Atarity/mixtape-alpha/HW/brd-preview.jpg

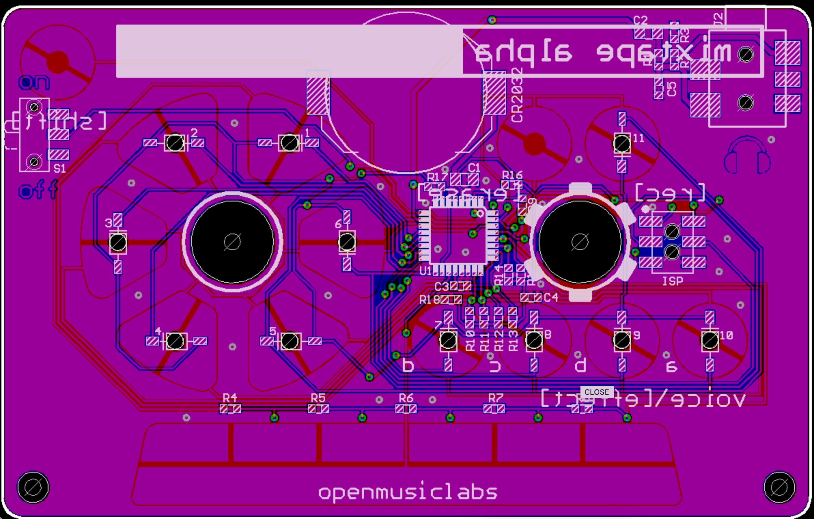
HW/brd-preview.jpg
