Atarity/mixtape-alpha/README.md

# Mixtape Alpha
This is Openmusiclabs project: http://wiki.openmusiclabs.com/wiki/MixtapeAlpha
