Atarity/mixtape-alpha/HW/mixtape2_bom.xlsx

Qty | Parts | Value | Package | Description
3 | C3, C4, C5 | .1uF | 0603-SM
2 | C1, C2 | 10uF | 0805/SMALL
1 | R1 | 100 | 0603-SM
8 | R2, R3, R4, R5, R6, R7, R8, R9 | 10k | 0603-SM
1 | R17 | 2.2k | 0603-SM
8 | R10, R11, R12, R13, R14, R15, R16, R18 | 22M | 0603-SM
11 | 1, 2, 3, 4, 5, 6, 7, 8, 9, 10, 11 | RED | SMD 2.5x2 | Kingbright KM2520SRC03
1 | U1 | ATMEGA328P | 32-TQFP-NOMOD
1 | J2 | Audio jack | 1/8JACK/STEREO/SMT 2SWITCHCUI3515 or KOBICONN2805 | SJ1-3515-SMT-GR
1 | BH1 | CR2032 BK-912 | Batterie holder for cr2032 | BTH-R36-20, L-KLS5-CR2032-09B
1 | S1 | JS102011 | SPDT angled SWITCH/SLIDE/JS102011 | JS102011SAQN
