Atarity/mixtape-alpha/(list of files, cad)

Other CAD files:
FW/mixtape_avr_new/mixtape.obj
