Atarity/mixtape-alpha/HW/mixtape2.brd

## EAGLE design HW/mixtape2.brd (2021-09-27)

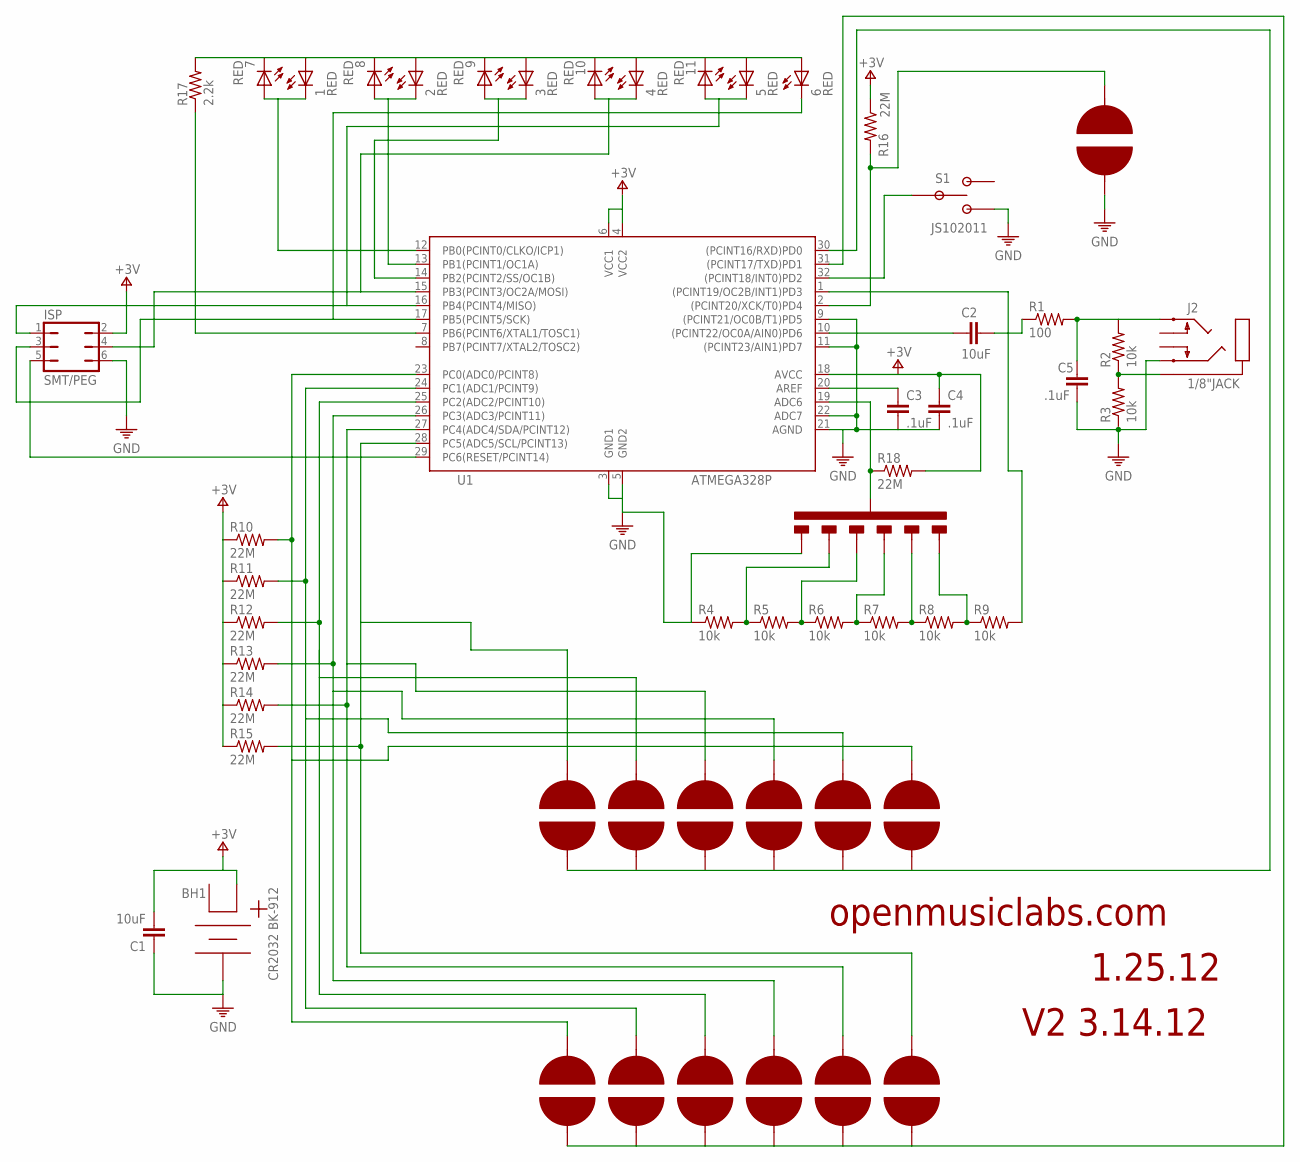
[picture p2: schematic mixtape2.sch]

Parts:
1, 2, 3, 4, 5, 6, 7, 8, 9, 10, 11: RED; LED-SMT-91-21
BH1: CR2032 BK-912; BAT-HOLD-BK-912
C1, C2: 10uF; 0805/SMALL
C3, C4, C5: .1uF; 0603-SM
ISP: SMT/PEG; JMP/6P/DIP/SMT/PEG
J2: 1/8"JACK; 1/8"JACK/STEREO/SMT
R1: 100; 0603-SM
R2, R3, R4, R5, R6, R7, R8, R9: 10k; 0603-SM
R10, R11, R12, R13, R14, R15, R16, R18: 22M; 0603-SM
R17: 2.2k; 0603-SM
S1: JS102011; SWITCH/SLIDE/JS102011
U1: ATMEGA328P; 32-TQFP-NOMOD
U$1: PAD/TOUCH/WHEEL
U$2, U$3, U$4, U$5, U$6, U$7, U$8: PAD/TOUCH; PAD/TOUCH/DOT
U$9: PAD/TOUCH/SLIDERSLIDER; PAD/TOUCH/SLIDER

Connections:
unnamed: R17.P$1 (1), U1.7 (PB6(PCINT6/XTAL1/TOSC1))
unnamed: U1.31 ((PCINT17/TXD)PD1), U$2.P$2, U$3.P$2, U$4.P$2, U$5.P$2, U$6.P$2, U$7.P$2
unnamed: R13.P$2 (2), U1.26 (PC3(ADC3/PCINT11)), U$1.P$7, U$5.P$1
unnamed: U1.30 ((PCINT16/RXD)PD0), U$1.P$2, U$1.P$4, U$1.P$6, U$1.P$8, U$1.P$10, U$1.P$12
unnamed: ISP.5, U1.29 (PC6(RESET/PCINT14))
unnamed: J2.P$1 (1), R2.P$1 (1), R3.P$2 (2)
unnamed: C2.1, R1.P$1 (1)
unnamed: C5.P$1 (1), J2.P$5 (5), R1.P$2 (2), R2.P$2 (2)
unnamed: C2.2, U1.10 ((PCINT22/OC0A/AIN0)PD6)
unnamed: S1.P$2, U1.32 ((PCINT18/INT0)PD2)
unnamed: C3.P$1 (1), U1.20 (AREF)
unnamed: R4.P$2 (2), R5.P$1 (1), U$9.P$6
unnamed: R5.P$2 (2), R6.P$1 (1), U$9.P$5
unnamed: R6.P$2 (2), R7.P$1 (1), U$9.P$4
unnamed: R8.P$2 (2), R9.P$1 (1), U$9.P$2
unnamed: R9.P$2 (2), U1.1 ((PCINT19/OC2B/INT1)PD3)
unnamed: 1.P$1 (C), 7.P$2 (A), U1.12 (PB0(PCINT0/CLKO/ICP1))
unnamed: 2.P$1 (C), 8.P$2 (A), U1.13 (PB1(PCINT1/OC1A))
unnamed: 3.P$1 (C), 9.P$2 (A), U1.14 (PB2(PCINT2/SS/OC1B))
unnamed: 4.P$1 (C), 10.P$2 (A), ISP.4, U1.15 (PB3(PCINT3/OC2A/MOSI))
unnamed: 5.P$1 (C), 11.P$2 (A), ISP.1, U1.16 (PB4(PCINT4/MISO))
unnamed: 1.P$2 (A), 2.P$2 (A), 3.P$2 (A), 4.P$2 (A), 5.P$2 (A), 6.P$2 (A), 7.P$1 (C), 8.P$1 (C), 9.P$1 (C), 10.P$1 (C), 11.P$1 (C), R17.P$2 (2)
unnamed: R16.P$2 (2), U1.2 ((PCINT20/XCK/T0)PD4), U$8.P$1
unnamed: R12.P$2 (2), U1.25 (PC2(ADC2/PCINT10)), U$1.P$3, U$4.P$1
unnamed: R14.P$2 (2), U1.27 (PC4(ADC4/SDA/PCINT12)), U$1.P$5, U$6.P$1
unnamed: R15.P$2 (2), U1.28 (PC5(ADC5/SCL/PCINT13)), U$1.P$1, U$7.P$1
unnamed: R18.P$1 (1), U1.19 (ADC6), U$9.P$1
unnamed: 6.P$1 (C), ISP.3, U1.17 (PB5(PCINT5/SCK))
unnamed: R11.P$2 (2), U1.24 (PC1(ADC1/PCINT9)), U$1.P$9, U$3.P$1
unnamed: R10.P$2 (2), U1.23 (PC0(ADC0/PCINT8)), U$1.P$11, U$2.P$1
unnamed: R7.P$2 (2), R8.P$1 (1), U$9.P$3
PE: BH1.P$3, C1.1, C3.P$2 (2), C4.P$2 (2), C5.P$2 (2), ISP.6, J2.P$3 (2), R3.P$1 (1), R4.P$1 (1), S1.P$1, U1.3 (GND1), U1.5 (GND2), U1.9 ((PCINT21/OC0B/T1)PD5), U1.11 ((PCINT23/AIN1)PD7), U1.21 (AGND), U1.22 (ADC7), U$8.P$2, U$9.P$7
V+: BH1.P$1, C1.2, C4.P$1 (1), ISP.2, R10.P$1 (1), R11.P$1 (1), R12.P$1 (1), R13.P$1 (1), R14.P$1 (1), R15.P$1 (1), R16.P$1 (1), R18.P$2 (2), U1.4 (VCC2), U1.6 (VCC1), U1.18 (AVCC)

Notes on the sheet:
openmusiclabs.com
1.25.12
V2 3.14.12

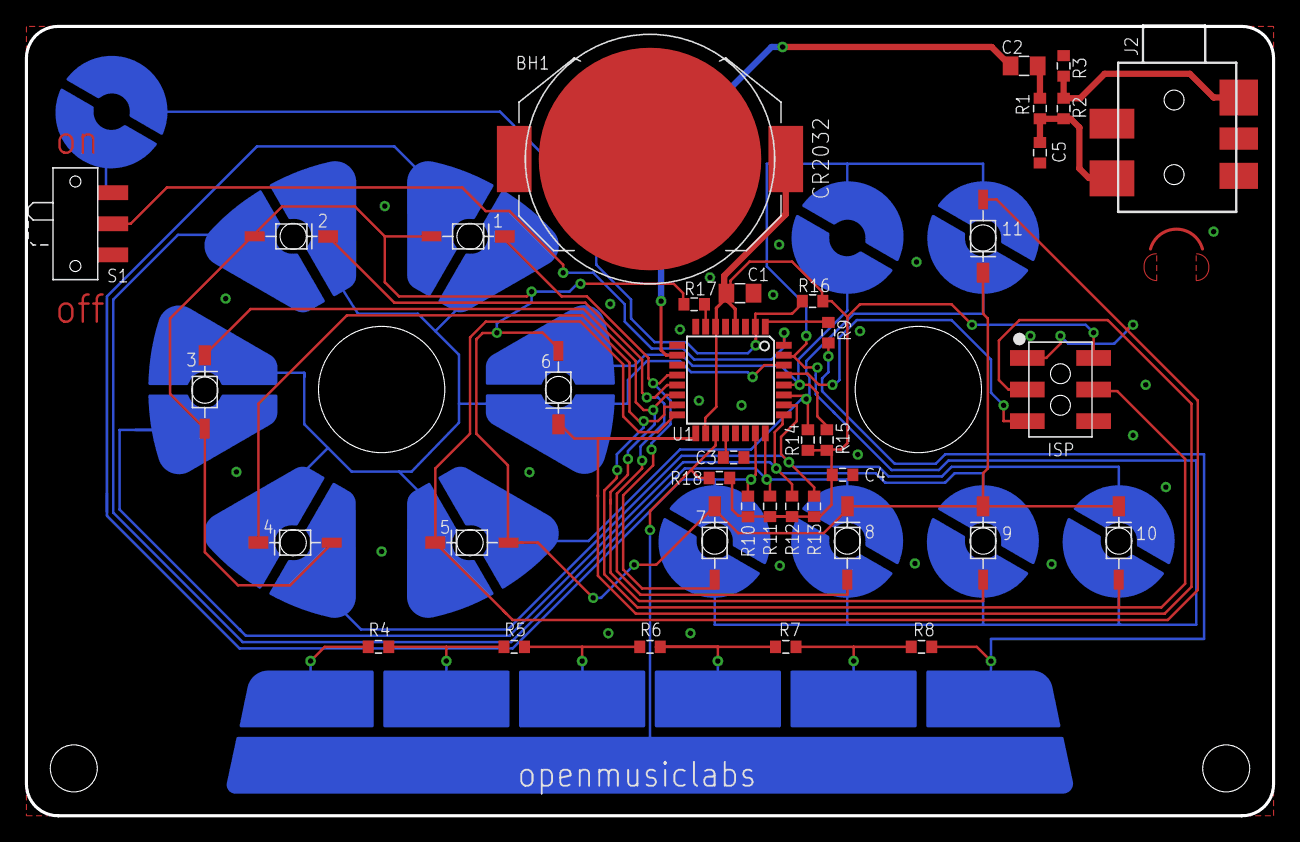
[picture p3: board mixtape2.brd from above]

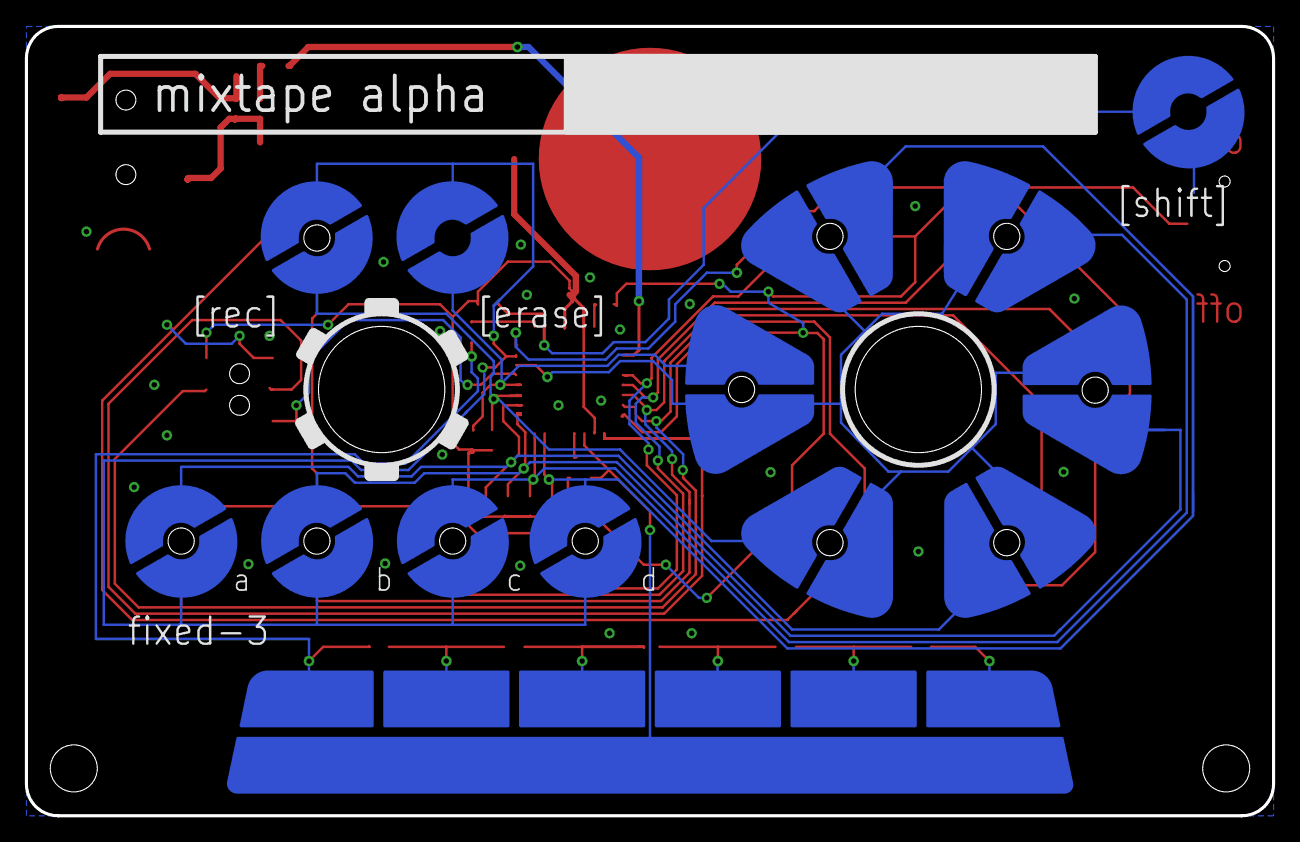
[picture p4: board mixtape2.brd from below]

Board: 2 copper layers, 100.3 x 63.5 mm, 48 parts (9 on the bottom side), 33 nets.
