Atarity/mixtape-alpha/(threads)

Thread 1 (2022-03-05):

Say No to War / нет войне

standbyukrainegit, 2022-03-05:
Fellow Russians,

We are endlessly grateful for your contribution to the world of open source; we believe this area has no borders, agnostic to one's beliefs. This is the space where we act as one and nationality is not important here. Despite the fact that this space is politics-free, we have to approach you with the following message.

For the first time since World War II, something we all believed would never happen again. The world is once again witnessing an unjustifiable act of aggression from Vladimir Putin and the people surrounding him. You are being lied by the Russian media propaganda - there is no fascism in Ukraine, nor coming from the western countries. Your soldiers are the attackers; nobody is welcoming them, and are being meaninglesly killed. Kids are getting shot at, hospitals are being bombed, and people in their shelters are praying to wake up with the next morning.

This is a call to action, for civil disobedience. Use your voice against Vladimir Putin’s one man’s war. Be vocal about the injustice that is going on in the world in your country. Or at least do not put any malicious code into your repositories. We know we ask a lot and we do not want you to suffer, but do not be silent. Resist. Do not help Putin. And for the sake of the World, say no to war!

#StayWithUkraine

——

Товарищи россияне,

Мы бесконечно благодарны за ваш вклад в мир открытого исходного кода, мы считаем, что эта область не имеет границ и не зависит от чьих-либо убеждений. Это пространство, где мы действуем как единое целое, и национальность здесь не имеет значения. Несмотря на то, что это пространство вне политики, мы вынуждены обратиться к вам со следующим сообщением.

Впервые со времен Второй мировой войны, которая, как мы все верили, больше никогда не повторится, мир в очередной раз стал свидетелем ничем не оправданного акта агрессии со стороны Владимира Путина и окружающих его людей. Вам лжет пропаганда российских СМИ - в Украине нет фашизма, и он не исходит из западных стран. Ваши солдаты — нападающие, их никто не приветствует и их бессмысленно убивают. В детей стреляют, больницы бомбят, а люди в убежащах молятся о том, чтобы проснуться утром.

Это призыв к действию, к гражданскому неповиновению. Используйте свой голос против войны одного человека Владимира Путина. Громко говорите о несправедливости, которая творится в мире и в вашей стране. Или, по крайней мере, не помещайте вредоносный код в свои репозитории. Мы знаем, что просим многого, и не хотим, чтобы вы страдали, но не молчите. Сопротивляйтесь. Не помогайте Путину. И ради всего Мира скажите нет войне!

#StayWithUkraine
